avakar/omicron2/v2.0/board/omicron2.brd

## EAGLE design v2.0/board/omicron2.brd (2013-05-29)

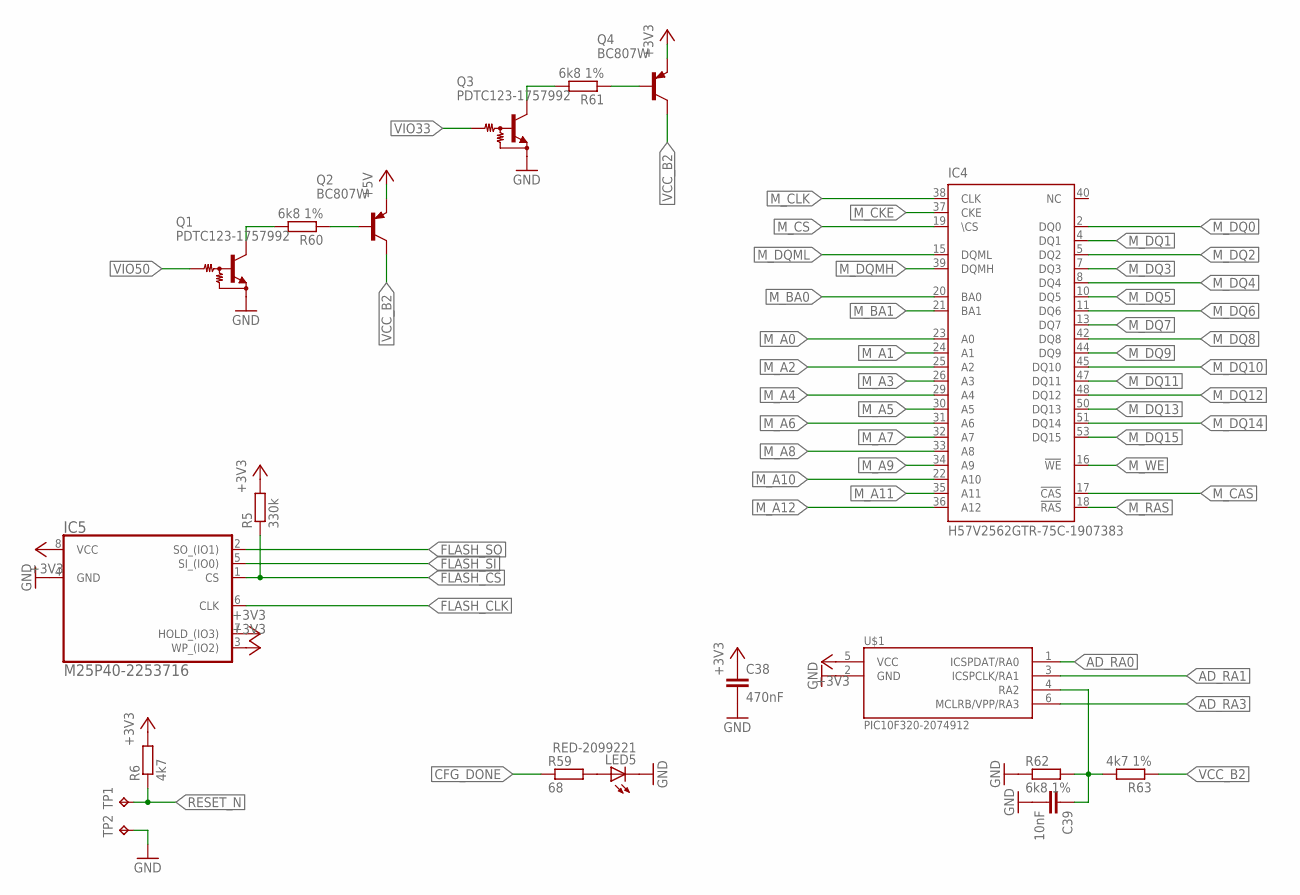
[picture p1: schematic omicron2.sch, sheet 1]

Parts:
C38: 470nF; C0603
C39: 10nF; C0603
IC4: H57V2562GTR-75C-1907383; TSOP54-400
IC5: M25P40-2253716; SO8
LED5: RED-2099221; CHIPLED_0603
Q1, Q3: PDTC123-1757992; SOT323
Q2, Q4: BC807W; SOT323-BEC
R5: 330k; R0603
R6: 4k7; R0603
R59: 68; R0603
R60, R61, R62: 6k8 1%; R0603
R63: 4k7 1%; R0603
TP1: TPTP15R; TP15R
TP2: TPTP20R; TP20R
U$1: PIC10F320-2074912; SOT23

Connections:
+3V3: C38.1, IC5.3 (WP_(IO2)), IC5.7 (HOLD_(IO3)), IC5.8 (VCC), Q4.2 (E), R5.2, R6.2, U$1.5 (VCC); also elsewhere on the board
+5V: Q2.2 (E); also elsewhere on the board
AD_RA0: U$1.1 (ICSPDAT/RA0); also elsewhere on the board
AD_RA1: U$1.3 (ICSPCLK/RA1); also elsewhere on the board
AD_RA3: U$1.6 (MCLRB/VPP/RA3); also elsewhere on the board
CFG_DONE: R59.1; also elsewhere on the board
FLASH_CLK: IC5.6 (CLK); also elsewhere on the board
FLASH_CS: IC5.1 (CS), R5.1; also elsewhere on the board
FLASH_SI: IC5.5 (SI_(IO0)); also elsewhere on the board
FLASH_SO: IC5.2 (SO_(IO1)); also elsewhere on the board
GND: C38.2, C39.2, IC5.4 (GND), LED5.C, Q1.2 (E), Q3.2 (E), R62.1, TP2.TP, U$1.2 (GND); also elsewhere on the board
M_A0: IC4.23 (A0); also elsewhere on the board
M_A1: IC4.24 (A1); also elsewhere on the board
M_A2: IC4.25 (A2); also elsewhere on the board
M_A3: IC4.26 (A3); also elsewhere on the board
M_A4: IC4.29 (A4); also elsewhere on the board
M_A5: IC4.30 (A5); also elsewhere on the board
M_A6: IC4.31 (A6); also elsewhere on the board
M_A7: IC4.32 (A7); also elsewhere on the board
M_A8: IC4.33 (A8); also elsewhere on the board
M_A9: IC4.34 (A9); also elsewhere on the board
M_A10: IC4.22 (A10); also elsewhere on the board
M_A11: IC4.35 (A11); also elsewhere on the board
M_A12: IC4.36 (A12); also elsewhere on the board
M_BA0: IC4.20 (BA0); also elsewhere on the board
M_BA1: IC4.21 (BA1); also elsewhere on the board
M_CAS: IC4.17 (!CAS); also elsewhere on the board
M_CKE: IC4.37 (CKE); also elsewhere on the board
M_CLK: IC4.38 (CLK); also elsewhere on the board
M_CS: IC4.19 (\CS); also elsewhere on the board
M_DQ0: IC4.2 (DQ0); also elsewhere on the board
M_DQ1: IC4.4 (DQ1); also elsewhere on the board
M_DQ2: IC4.5 (DQ2); also elsewhere on the board
M_DQ3: IC4.7 (DQ3); also elsewhere on the board
M_DQ4: IC4.8 (DQ4); also elsewhere on the board
M_DQ5: IC4.10 (DQ5); also elsewhere on the board
M_DQ6: IC4.11 (DQ6); also elsewhere on the board
M_DQ7: IC4.13 (DQ7); also elsewhere on the board
M_DQ8: IC4.42 (DQ8); also elsewhere on the board
M_DQ9: IC4.44 (DQ9); also elsewhere on the board
M_DQ10: IC4.45 (DQ10); also elsewhere on the board
M_DQ11: IC4.47 (DQ11); also elsewhere on the board
M_DQ12: IC4.48 (DQ12); also elsewhere on the board
M_DQ13: IC4.50 (DQ13); also elsewhere on the board
M_DQ14: IC4.51 (DQ14); also elsewhere on the board
M_DQ15: IC4.53 (DQ15); also elsewhere on the board
M_DQMH: IC4.39 (DQMH); also elsewhere on the board
M_DQML: IC4.15 (DQML); also elsewhere on the board
M_RAS: IC4.18 (!RAS); also elsewhere on the board
M_WE: IC4.16 (!WE); also elsewhere on the board
unnamed: LED5.A, R59.2
unnamed: Q2.1 (B), R60.1
unnamed: Q1.3 (C), R60.2
unnamed: Q4.1 (B), R61.1
unnamed: Q3.3 (C), R61.2
unnamed: C39.1, R62.2, R63.2, U$1.4 (RA2)
RESET_N: R6.1, TP1.TP; also elsewhere on the board
VCC_B2: Q2.3 (C), Q4.3 (C), R63.1; also elsewhere on the board
VIO33: Q3.1 (B); also elsewhere on the board
VIO50: Q1.1 (B); also elsewhere on the board

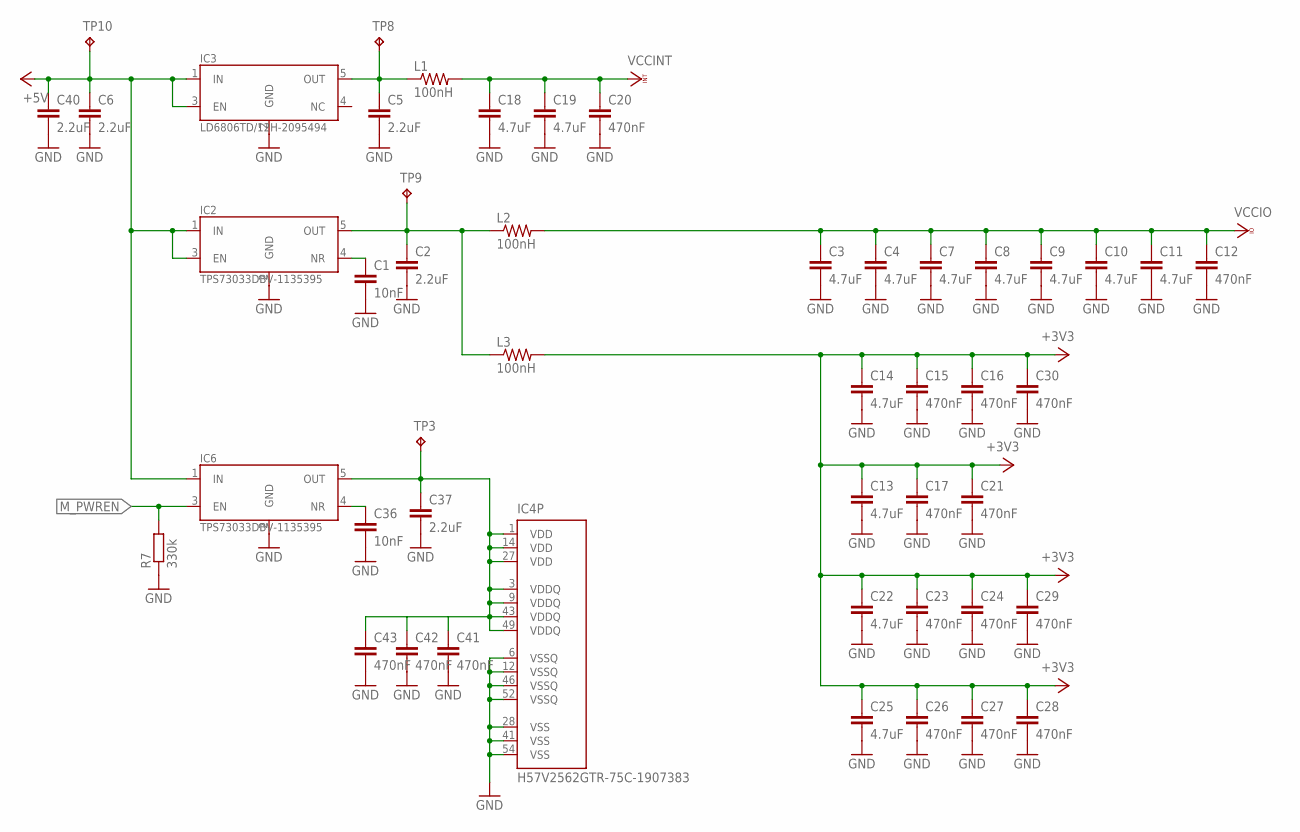
[picture p2: schematic omicron2.sch, sheet 2]

Parts:
C1, C36: 10nF; C0603
C2, C5, C6, C37, C40: 2.2uF; C0603
C3, C4, C7, C8, C9, C10, C11, C13, C14, C18, C19, C22, C25: 4.7uF; C0603
C12, C15, C16, C17, C20, C21, C23, C24, C26, C27, C28, C29, C30, C41, C42, C43: 470nF; C0603
IC2, IC6: TPS73033DBV-1135395; SOT23-DBV
IC3: LD6806TD/12H-2095494; SOT23-DBV
IC4: H57V2562GTR-75C-1907383; TSOP54-400
L1, L2, L3: 100nH; R0805
R7: 330k; R0603
TP3, TP8, TP9, TP10: TPTP15R; TP15R

Connections:
+3V3: C13.1, C14.1, C15.1, C16.1, C17.1, C21.1, C22.1, C23.1, C24.1, C25.1, C26.1, C27.1, C28.1, C29.1, C30.1, L3.2; also elsewhere on the board
+5V: C6.1, C40.1, IC2.1 (IN), IC2.3 (EN), IC3.1 (IN), IC3.3 (EN), IC6.1 (IN), TP10.TP; also elsewhere on the board
GND: C1.2, C2.2, C3.2, C4.2, C5.2, C6.2, C7.2, C8.2, C9.2, C10.2, C11.2, C12.2, C13.2, C14.2, C15.2, C16.2, C17.2, C18.2, C19.2, C20.2, C21.2, C22.2, C23.2, C24.2, C25.2, C26.2, C27.2, C28.2, C29.2, C30.2, C36.2, C37.2, C40.2, C41.2, C42.2, C43.2, IC2.2 (GND), IC3.2 (GND), IC4.6 (VSSQ), IC4.12 (VSSQ), IC4.28 (VSS), IC4.41 (VSS), IC4.46 (VSSQ), IC4.52 (VSSQ), IC4.54 (VSS), IC6.2 (GND), R7.1; also elsewhere on the board
M_PWREN: IC6.3 (EN), R7.2; also elsewhere on the board
unnamed: C1.1, IC2.4 (NR)
unnamed: C5.1, IC3.5 (OUT), L1.1, TP8.TP
unnamed: C2.1, IC2.5 (OUT), L2.1, L3.1, TP9.TP
unnamed: C36.1, IC6.4 (NR)
VCCINT: C18.1, C19.1, C20.1, L1.2; also elsewhere on the board
VCCIO: C3.1, C4.1, C7.1, C8.1, C9.1, C10.1, C11.1, C12.1, L2.2; also elsewhere on the board
VCC_MEM: C37.1, C41.1, C42.1, C43.1, IC4.1 (VDD), IC4.3 (VDDQ), IC4.9 (VDDQ), IC4.14 (VDD), IC4.27 (VDD), IC4.43 (VDDQ), IC4.49 (VDDQ), IC6.5 (OUT), TP3.TP

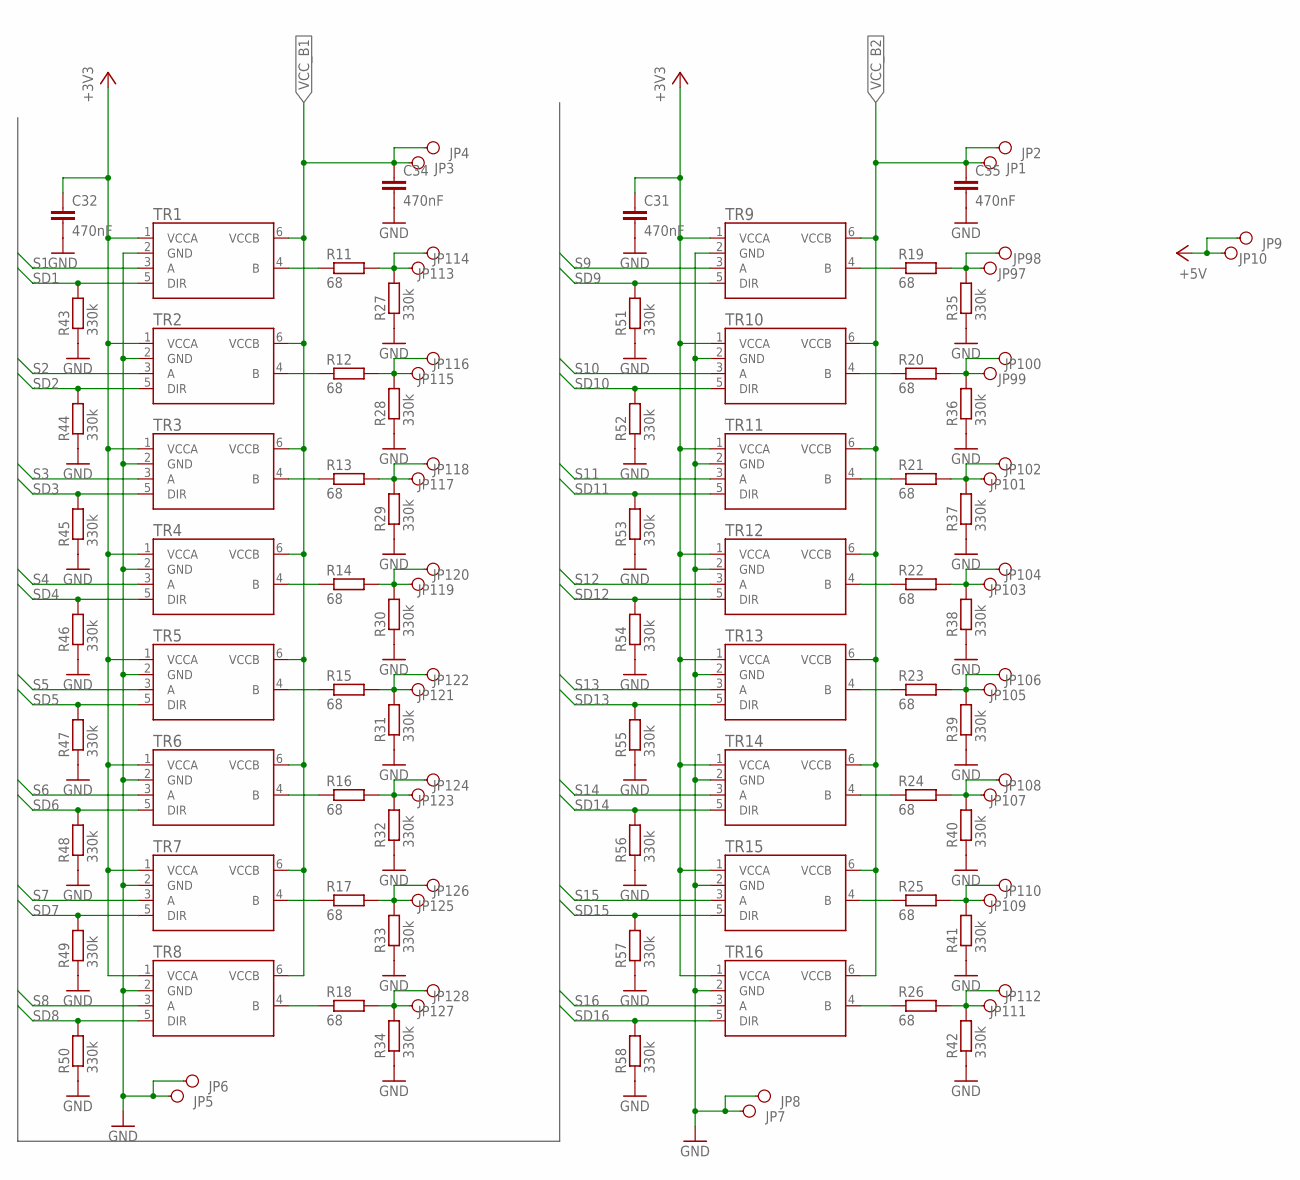
[picture p3: schematic omicron2.sch, sheet 3]

Parts:
C31, C32, C34, C35: 470nF; C0603
JP1, JP2, JP3, JP4, JP5, JP6, JP7, JP8, JP9, JP10, JP97, JP98, JP99, JP100, JP101, JP102, JP103, JP104, JP105, JP106, JP107, JP108, JP109, JP110, JP111, JP112, JP113, JP114, JP115, JP116, JP117, JP118, JP119, JP120, JP121, JP122, JP123, JP124, JP125, JP126, JP127, JP128: PINH1X01SMD
R11, R12, R13, R14, R15, R16, R17, R18, R19, R20, R21, R22, R23, R24, R25, R26: 68; R0603
R27, R28, R29, R30, R31, R32, R33, R34, R35, R36, R37, R38, R39, R40, R41, R42, R43, R44, R45, R46, R47, R48, R49, R50, R51, R52, R53, R54, R55, R56, R57, R58: 330k; R0603
TR1, TR2, TR3, TR4, TR5, TR6, TR7, TR8, TR9, TR10, TR11, TR12, TR13, TR14, TR15, TR16: 74LVC1T45DBV; SOT236

Connections:
+3V3: C31.1, C32.1, TR1.1 (VCCA), TR2.1 (VCCA), TR3.1 (VCCA), TR4.1 (VCCA), TR5.1 (VCCA), TR6.1 (VCCA), TR7.1 (VCCA), TR8.1 (VCCA), TR9.1 (VCCA), TR10.1 (VCCA), TR11.1 (VCCA), TR12.1 (VCCA), TR13.1 (VCCA), TR14.1 (VCCA), TR15.1 (VCCA), TR16.1 (VCCA); also elsewhere on the board
+5V: JP9.1, JP10.1; also elsewhere on the board
GND: C31.2, C32.2, C34.2, C35.2, JP5.1, JP6.1, JP7.1, JP8.1, R27.1, R28.1, R29.1, R30.1, R31.1, R32.1, R33.1, R34.1, R35.1, R36.1, R37.1, R38.1, R39.1, R40.1, R41.1, R42.1, R43.1, R44.1, R45.1, R46.1, R47.1, R48.1, R49.1, R50.1, R51.1, R52.1, R53.1, R54.1, R55.1, R56.1, R57.1, R58.1, TR1.2 (GND), TR2.2 (GND), TR3.2 (GND), TR4.2 (GND), TR5.2 (GND), TR6.2 (GND), TR7.2 (GND), TR8.2 (GND), TR9.2 (GND), TR10.2 (GND), TR11.2 (GND), TR12.2 (GND), TR13.2 (GND), TR14.2 (GND), TR15.2 (GND), TR16.2 (GND); also elsewhere on the board
IO1: JP113.1, JP114.1, R11.2, R27.2
IO2: JP115.1, JP116.1, R12.2, R28.2
IO3: JP117.1, JP118.1, R13.2, R29.2
IO4: JP119.1, JP120.1, R14.2, R30.2
IO5: JP121.1, JP122.1, R15.2, R31.2
IO6: JP123.1, JP124.1, R16.2, R32.2
IO7: JP125.1, JP126.1, R17.2, R33.2
IO8: JP127.1, JP128.1, R18.2, R34.2
IO9: JP97.1, JP98.1, R19.2, R35.2
IO10: JP99.1, JP100.1, R20.2, R36.2
IO11: JP101.1, JP102.1, R21.2, R37.2
IO12: JP103.1, JP104.1, R22.2, R38.2
IO13: JP105.1, JP106.1, R23.2, R39.2
IO14: JP107.1, JP108.1, R24.2, R40.2
IO15: JP109.1, JP110.1, R25.2, R41.2
IO16: JP111.1, JP112.1, R26.2, R42.2
unnamed: R11.1, TR1.4 (B)
unnamed: R12.1, TR2.4 (B)
unnamed: R13.1, TR3.4 (B)
unnamed: R14.1, TR4.4 (B)
unnamed: R15.1, TR5.4 (B)
unnamed: R16.1, TR6.4 (B)
unnamed: R17.1, TR7.4 (B)
unnamed: R18.1, TR8.4 (B)
unnamed: R19.1, TR9.4 (B)
unnamed: R20.1, TR10.4 (B)
unnamed: R21.1, TR11.4 (B)
unnamed: R22.1, TR12.4 (B)
unnamed: R23.1, TR13.4 (B)
unnamed: R24.1, TR14.4 (B)
unnamed: R25.1, TR15.4 (B)
unnamed: R26.1, TR16.4 (B)
S1: TR1.3 (A); also elsewhere on the board
S2: TR2.3 (A); also elsewhere on the board
S3: TR3.3 (A); also elsewhere on the board
S4: TR4.3 (A); also elsewhere on the board
S5: TR5.3 (A); also elsewhere on the board
S6: TR6.3 (A); also elsewhere on the board
S7: TR7.3 (A); also elsewhere on the board
S8: TR8.3 (A); also elsewhere on the board
S9: TR9.3 (A); also elsewhere on the board
S10: TR10.3 (A); also elsewhere on the board
S11: TR11.3 (A); also elsewhere on the board
S12: TR12.3 (A); also elsewhere on the board
S13: TR13.3 (A); also elsewhere on the board
S14: TR14.3 (A); also elsewhere on the board
S15: TR15.3 (A); also elsewhere on the board
S16: TR16.3 (A); also elsewhere on the board
SD1: R43.2, TR1.5 (DIR); also elsewhere on the board
SD2: R44.2, TR2.5 (DIR); also elsewhere on the board
SD3: R45.2, TR3.5 (DIR); also elsewhere on the board
SD4: R46.2, TR4.5 (DIR); also elsewhere on the board
SD5: R47.2, TR5.5 (DIR); also elsewhere on the board
SD6: R48.2, TR6.5 (DIR); also elsewhere on the board
SD7: R49.2, TR7.5 (DIR); also elsewhere on the board
SD8: R50.2, TR8.5 (DIR); also elsewhere on the board
SD9: R51.2, TR9.5 (DIR); also elsewhere on the board
SD10: R52.2, TR10.5 (DIR); also elsewhere on the board
SD11: R53.2, TR11.5 (DIR); also elsewhere on the board
SD12: R54.2, TR12.5 (DIR); also elsewhere on the board
SD13: R55.2, TR13.5 (DIR); also elsewhere on the board
SD14: R56.2, TR14.5 (DIR); also elsewhere on the board
SD15: R57.2, TR15.5 (DIR); also elsewhere on the board
SD16: R58.2, TR16.5 (DIR); also elsewhere on the board
VCC_B1: C34.1, JP3.1, JP4.1, TR1.6 (VCCB), TR2.6 (VCCB), TR3.6 (VCCB), TR4.6 (VCCB), TR5.6 (VCCB), TR6.6 (VCCB), TR7.6 (VCCB), TR8.6 (VCCB)
VCC_B2: C35.1, JP1.1, JP2.1, TR9.6 (VCCB), TR10.6 (VCCB), TR11.6 (VCCB), TR12.6 (VCCB), TR13.6 (VCCB), TR14.6 (VCCB), TR15.6 (VCCB), TR16.6 (VCCB); also elsewhere on the board

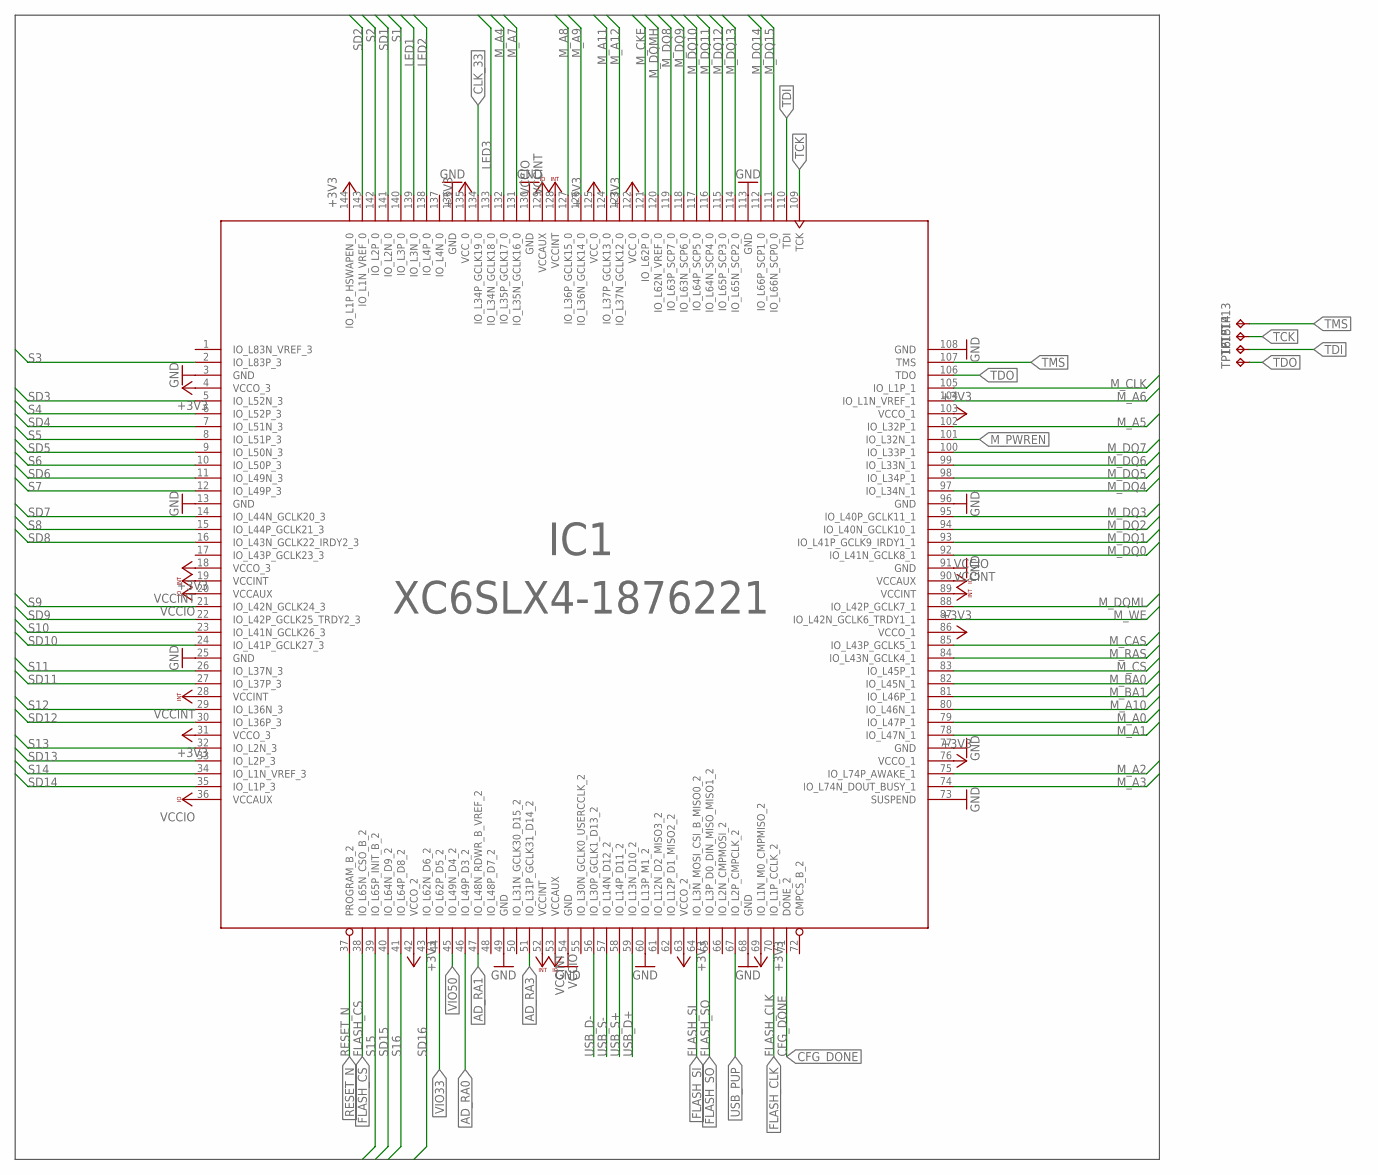
[picture p4: schematic omicron2.sch, sheet 4]

Parts:
IC1: XC6SLX4-1876221; TQG144
TP13, TP14, TP15, TP16: TPTP20R; TP20R

Connections:
+3V3: IC1.4 (VCCO_3), IC1.18 (VCCO_3), IC1.31 (VCCO_3), IC1.42 (VCCO_2), IC1.63 (VCCO_2), IC1.69 (IO_L1N_M0_CMPMISO_2), IC1.76 (VCCO_1), IC1.86 (VCCO_1), IC1.103 (VCCO_1), IC1.122 (VCC_0), IC1.125 (VCC_0), IC1.135 (VCC_0), IC1.144 (IO_L1P_HSWAPEN_0); also elsewhere on the board
AD_RA0: IC1.46 (IO_L49P_D3_2); also elsewhere on the board
AD_RA1: IC1.47 (IO_L48N_RDWR_B_VREF_2); also elsewhere on the board
AD_RA3: IC1.51 (IO_L31P_GCLK31_D14_2); also elsewhere on the board
CFG_DONE: IC1.71 (DONE_2); also elsewhere on the board
CLK_33: IC1.134 (IO_L34P_GCLK19_0); also elsewhere on the board
FLASH_CLK: IC1.70 (IO_L1P_CCLK_2); also elsewhere on the board
FLASH_CS: IC1.38 (IO_L65N_CSO_B_2); also elsewhere on the board
FLASH_SI: IC1.64 (IO_L3N_MOSI_CSI_B_MISO0_2); also elsewhere on the board
FLASH_SO: IC1.65 (IO_L3P_D0_DIN_MISO_MISO1_2); also elsewhere on the board
GND: IC1.3 (GND), IC1.13 (GND), IC1.25 (GND), IC1.49 (GND), IC1.54 (GND), IC1.60 (IO_L13P_M1_2), IC1.68 (GND), IC1.73 (SUSPEND), IC1.77 (GND), IC1.91 (GND), IC1.96 (GND), IC1.108 (GND), IC1.113 (GND), IC1.130 (GND), IC1.136 (GND); also elsewhere on the board
LED1: IC1.139 (IO_L3N_0); also elsewhere on the board
LED2: IC1.138 (IO_L4P_0); also elsewhere on the board
LED3: IC1.133 (IO_L34N_GCLK18_0); also elsewhere on the board
M_A0: IC1.79 (IO_L47P_1); also elsewhere on the board
M_A1: IC1.78 (IO_L47N_1); also elsewhere on the board
M_A2: IC1.75 (IO_L74P_AWAKE_1); also elsewhere on the board
M_A3: IC1.74 (IO_L74N_DOUT_BUSY_1); also elsewhere on the board
M_A4: IC1.132 (IO_L35P_GCLK17_0); also elsewhere on the board
M_A5: IC1.102 (IO_L32P_1); also elsewhere on the board
M_A6: IC1.104 (IO_L1N_VREF_1); also elsewhere on the board
M_A7: IC1.131 (IO_L35N_GCLK16_0); also elsewhere on the board
M_A8: IC1.127 (IO_L36P_GCLK15_0); also elsewhere on the board
M_A9: IC1.126 (IO_L36N_GCLK14_0); also elsewhere on the board
M_A10: IC1.80 (IO_L46N_1); also elsewhere on the board
M_A11: IC1.124 (IO_L37P_GCLK13_0); also elsewhere on the board
M_A12: IC1.123 (IO_L37N_GCLK12_0); also elsewhere on the board
M_BA0: IC1.82 (IO_L45N_1); also elsewhere on the board
M_BA1: IC1.81 (IO_L46P_1); also elsewhere on the board
M_CAS: IC1.85 (IO_L43P_GCLK5_1); also elsewhere on the board
M_CKE: IC1.121 (IO_L62P_0); also elsewhere on the board
M_CLK: IC1.105 (IO_L1P_1); also elsewhere on the board
M_CS: IC1.83 (IO_L45P_1); also elsewhere on the board
M_DQ0: IC1.92 (IO_L41N_GCLK8_1); also elsewhere on the board
M_DQ1: IC1.93 (IO_L41P_GCLK9_IRDY1_1); also elsewhere on the board
M_DQ2: IC1.94 (IO_L40N_GCLK10_1); also elsewhere on the board
M_DQ3: IC1.95 (IO_L40P_GCLK11_1); also elsewhere on the board
M_DQ4: IC1.97 (IO_L34N_1); also elsewhere on the board
M_DQ5: IC1.98 (IO_L34P_1); also elsewhere on the board
M_DQ6: IC1.99 (IO_L33N_1); also elsewhere on the board
M_DQ7: IC1.100 (IO_L33P_1); also elsewhere on the board
M_DQ8: IC1.119 (IO_L63P_SCP7_0); also elsewhere on the board
M_DQ9: IC1.118 (IO_L63N_SCP6_0); also elsewhere on the board
M_DQ10: IC1.117 (IO_L64P_SCP5_0); also elsewhere on the board
M_DQ11: IC1.116 (IO_L64N_SCP4_0); also elsewhere on the board
M_DQ12: IC1.115 (IO_L65P_SCP3_0); also elsewhere on the board
M_DQ13: IC1.114 (IO_L65N_SCP2_0); also elsewhere on the board
M_DQ14: IC1.112 (IO_L66P_SCP1_0); also elsewhere on the board
M_DQ15: IC1.111 (IO_L66N_SCP0_0); also elsewhere on the board
M_DQMH: IC1.120 (IO_L62N_VREF_0); also elsewhere on the board
M_DQML: IC1.88 (IO_L42P_GCLK7_1); also elsewhere on the board
M_PWREN: IC1.101 (IO_L32N_1); also elsewhere on the board
M_RAS: IC1.84 (IO_L43N_GCLK4_1); also elsewhere on the board
M_WE: IC1.87 (IO_L42N_GCLK6_TRDY1_1); also elsewhere on the board
RESET_N: IC1.37 (PROGRAM_B_2); also elsewhere on the board
S1: IC1.140 (IO_L3P_0); also elsewhere on the board
S2: IC1.142 (IO_L2P_0); also elsewhere on the board
S3: IC1.2 (IO_L83P_3); also elsewhere on the board
S4: IC1.6 (IO_L52P_3); also elsewhere on the board
S5: IC1.8 (IO_L51P_3); also elsewhere on the board
S6: IC1.10 (IO_L50P_3); also elsewhere on the board
S7: IC1.12 (IO_L49P_3); also elsewhere on the board
S8: IC1.15 (IO_L44P_GCLK21_3); also elsewhere on the board
S9: IC1.21 (IO_L42N_GCLK24_3); also elsewhere on the board
S10: IC1.23 (IO_L41N_GCLK26_3); also elsewhere on the board
S11: IC1.26 (IO_L37N_3); also elsewhere on the board
S12: IC1.29 (IO_L36N_3); also elsewhere on the board
S13: IC1.32 (IO_L2N_3); also elsewhere on the board
S14: IC1.34 (IO_L1N_VREF_3); also elsewhere on the board
S15: IC1.39 (IO_L65P_INIT_B_2); also elsewhere on the board
S16: IC1.41 (IO_L64P_D8_2); also elsewhere on the board
SD1: IC1.141 (IO_L2N_0); also elsewhere on the board
SD2: IC1.143 (IO_L1N_VREF_0); also elsewhere on the board
SD3: IC1.5 (IO_L52N_3); also elsewhere on the board
SD4: IC1.7 (IO_L51N_3); also elsewhere on the board
SD5: IC1.9 (IO_L50N_3); also elsewhere on the board
SD6: IC1.11 (IO_L49N_3); also elsewhere on the board
SD7: IC1.14 (IO_L44N_GCLK20_3); also elsewhere on the board
SD8: IC1.16 (IO_L43N_GCLK22_IRDY2_3); also elsewhere on the board
SD9: IC1.22 (IO_L42P_GCLK25_TRDY2_3); also elsewhere on the board
SD10: IC1.24 (IO_L41P_GCLK27_3); also elsewhere on the board
SD11: IC1.27 (IO_L37P_3); also elsewhere on the board
SD12: IC1.30 (IO_L36P_3); also elsewhere on the board
SD13: IC1.33 (IO_L2P_3); also elsewhere on the board
SD14: IC1.35 (IO_L1P_3); also elsewhere on the board
SD15: IC1.40 (IO_L64N_D9_2); also elsewhere on the board
SD16: IC1.43 (IO_L62N_D6_2); also elsewhere on the board
TCK: IC1.109 (TCK), TP14.TP
TDI: IC1.110 (TDI), TP15.TP
TDO: IC1.106 (TDO), TP16.TP
TMS: IC1.107 (TMS), TP13.TP
USB_D+: IC1.59 (IO_L13N_D10_2); also elsewhere on the board
USB_D-: IC1.56 (IO_L30P_GCLK1_D13_2); also elsewhere on the board
USB_PUP: IC1.67 (IO_L2P_CMPCLK_2); also elsewhere on the board
USB_S+: IC1.58 (IO_L14P_D11_2); also elsewhere on the board
USB_S-: IC1.57 (IO_L14N_D12_2); also elsewhere on the board
VCCINT: IC1.19 (VCCINT), IC1.28 (VCCINT), IC1.52 (VCCINT), IC1.89 (VCCINT), IC1.128 (VCCINT); also elsewhere on the board
VCCIO: IC1.20 (VCCAUX), IC1.36 (VCCAUX), IC1.53 (VCCAUX), IC1.90 (VCCAUX), IC1.129 (VCCAUX); also elsewhere on the board
VIO33: IC1.44 (IO_L62P_D5_2); also elsewhere on the board
VIO50: IC1.45 (IO_L49N_D4_2); also elsewhere on the board

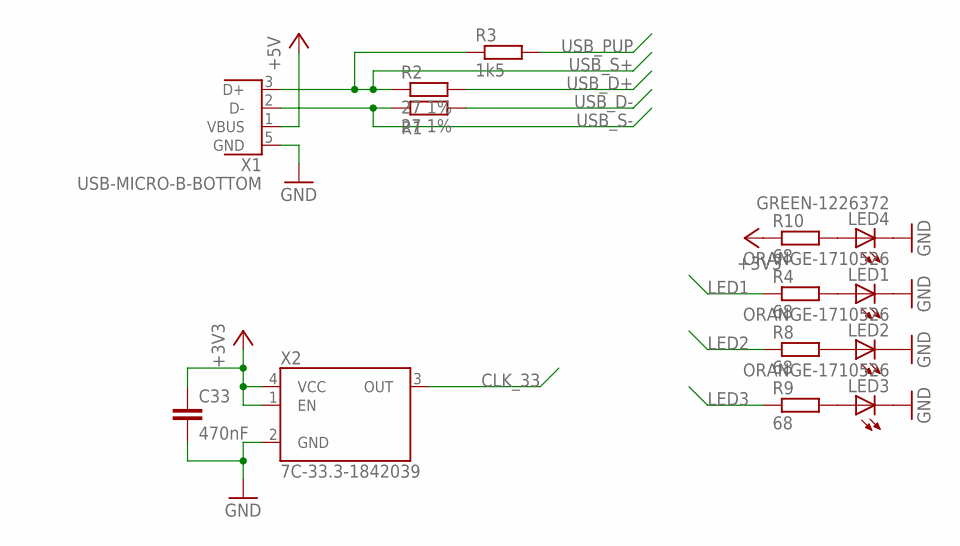
[picture p5: schematic omicron2.sch, sheet 5]

Parts:
C33: 470nF; C0603
LED1, LED2, LED3: ORANGE-1710526; CHIPLED_0603
LED4: GREEN-1226372; CHIPLED_0603
R1, R2: 27 1%; R0603
R3: 1k5; R0603
R4, R8, R9, R10: 68; R0603
X1: USB-MICRO-B-BOTTOM; USB-MICRO-B-BOTTOM-MOLEX
X2: 7C-33.3-1842039; 5X3.2_HAND

Connections:
+3V3: C33.1, R10.1, X2.1 (EN), X2.4 (VCC); also elsewhere on the board
+5V: X1.1 (VBUS); also elsewhere on the board
CLK_33: X2.3 (OUT); also elsewhere on the board
GND: C33.2, LED1.C, LED2.C, LED3.C, LED4.C, X1.5 (GND), X2.2 (GND); also elsewhere on the board
LED1: R4.1; also elsewhere on the board
LED2: R8.1; also elsewhere on the board
LED3: R9.1; also elsewhere on the board
unnamed: LED1.A, R4.2
unnamed: LED2.A, R8.2
unnamed: LED3.A, R9.2
unnamed: LED4.A, R10.2
USB_D+: R2.2; also elsewhere on the board
USB_D-: R1.2; also elsewhere on the board
USB_PUP: R3.2; also elsewhere on the board
USB_S+: R2.1, R3.1, X1.3 (D+); also elsewhere on the board
USB_S-: R1.1, X1.2 (D-); also elsewhere on the board

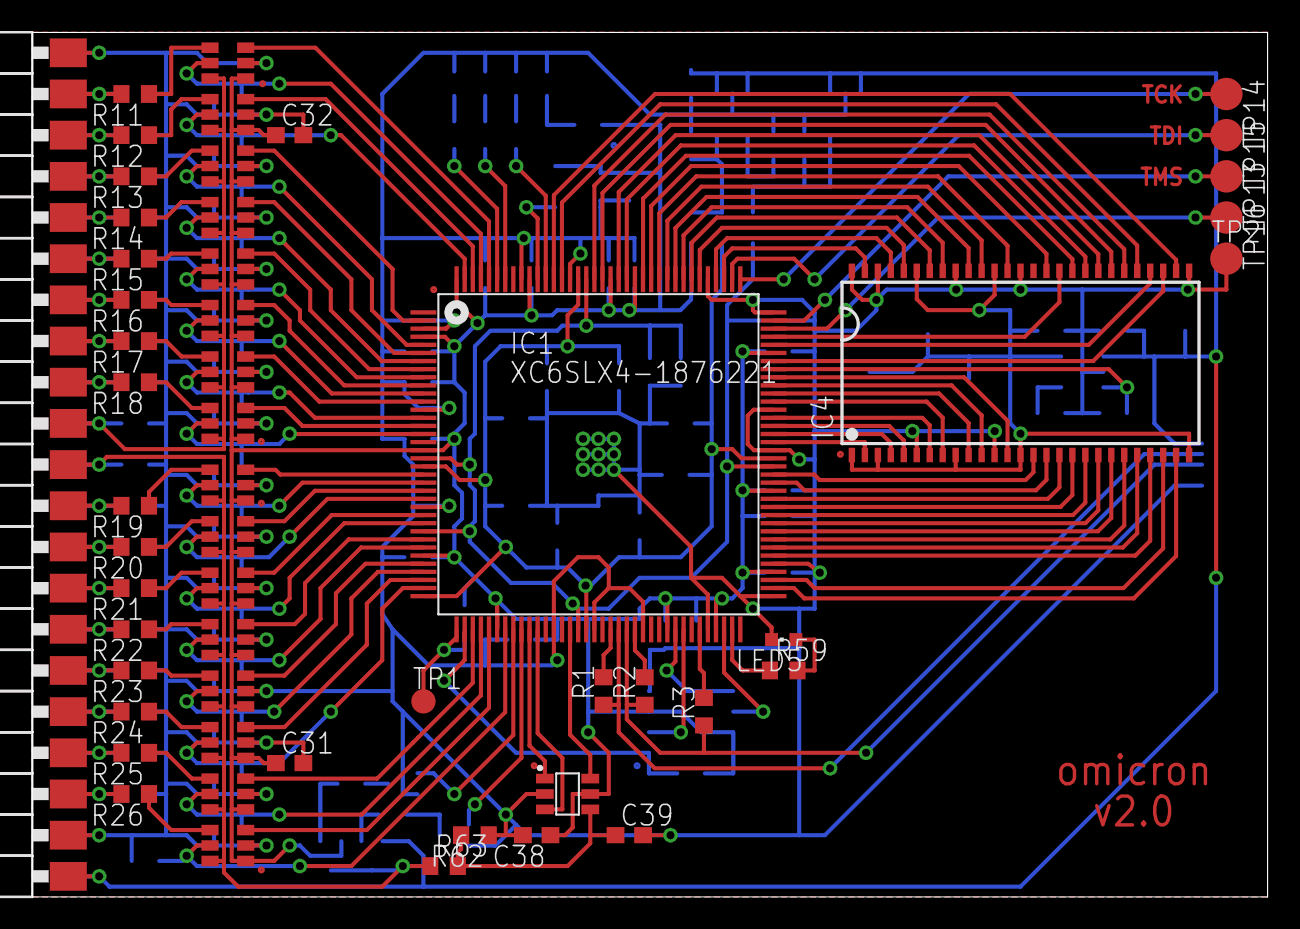
[picture p6: board omicron2.brd from above]

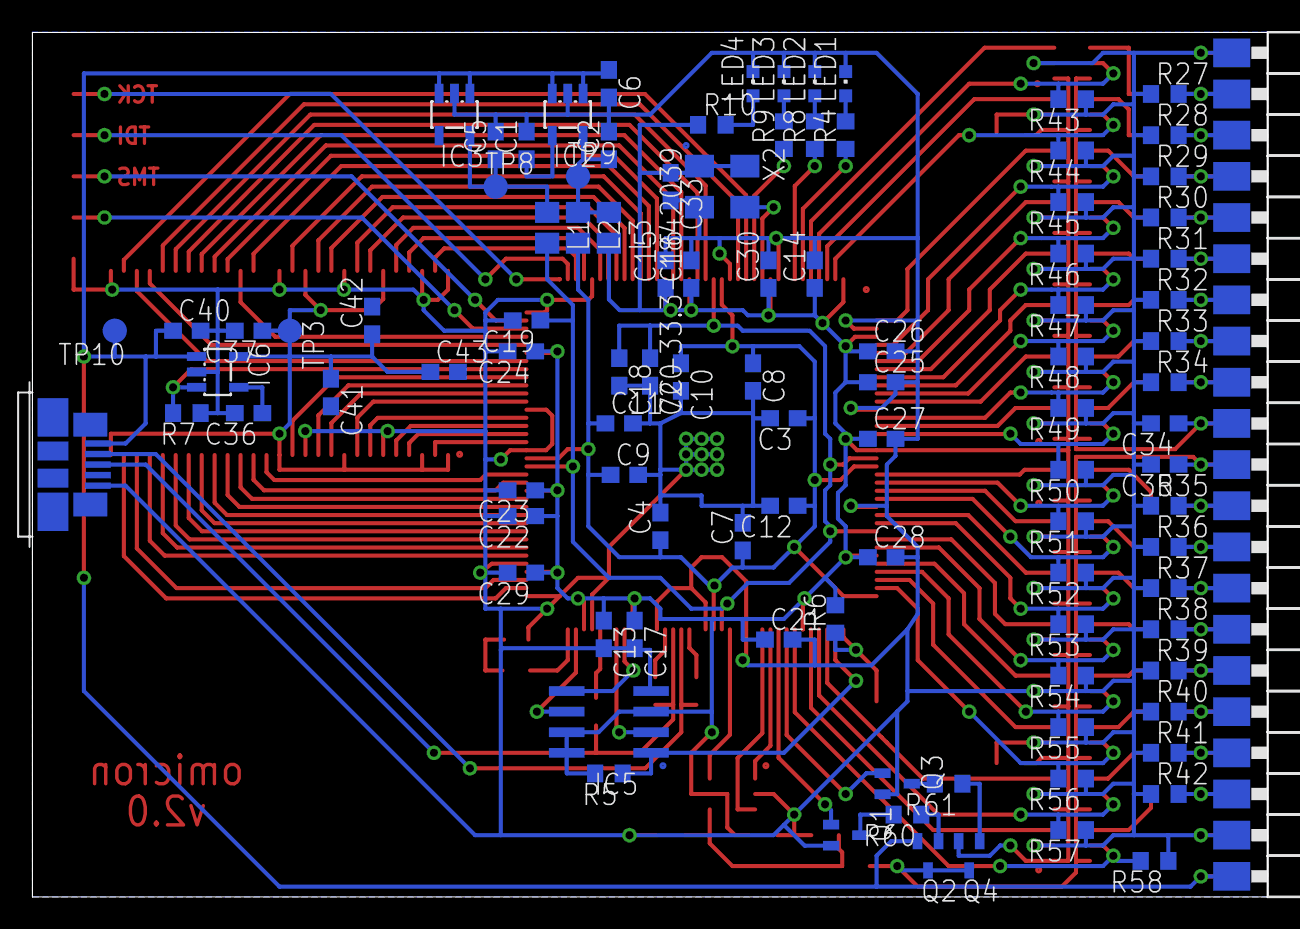
[picture p7: board omicron2.brd from below]

Board: 2 copper layers, 76.2 x 53.3 mm, 195 parts (122 on the bottom side), 150 nets.
