avakar/omicron2/v2.0/design/ipcore_dir/workspace/sw_0/src/main.cc

/*
 * Empty C++ Application
 */

#include <stdint.h>
#include <stdlib.h>
#include <string.h>

#define PROGMEM
#include "descs.h"

#define UART_RX     *((uint32_t volatile *)0x80000000)
#define UART_TX     *((uint32_t volatile *)0x80000004)
#define UART_STATUS *((uint32_t volatile *)0x80000008)
#define UART_TX_USED_bm  (1<<3)
#define UART_RX_VALID_bm (1<<0)

#define USB_CTRL    *((uint32_t volatile *)0xC0000000)
#define USB_ATTACH    (1<<0)
#define USB_RESET_IF  (1<<1)
#define USB_RESET_CLR (1<<2)
#define USB_ADDRESS *((uint32_t volatile *)0xC0000004)

#define USB_EP0_OUT_CTRL *((uint32_t volatile *)0xC0000100)
#define USB_EP0_IN_CTRL  *((uint32_t volatile *)0xC0000104)

#define USB_EP1_OUT_CTRL *((uint32_t volatile *)0xC0000110)
#define USB_EP1_IN_CTRL  *((uint32_t volatile *)0xC0000114)

#define USB_EP_OUT_CNT(x) ((uint8_t)(((x) >> 8) & 0x3f))
#define USB_EP_IN_CNT(x)  ((uint8_t)(x) << 8)

#define USB_EP_TOGGLE     (1<<5)
#define USB_EP_TOGGLE_SET (1<<6)
#define USB_EP_TOGGLE_CLR (1<<7)
#define USB_EP_STALL      (1<<4)
#define USB_EP_SETUP_CLR  (1<<3)
#define USB_EP_SETUP      (1<<2)
#define USB_EP_FULL_CLR   (1<<1)
#define USB_EP_FULL       (1<<0)

#define USB_EP0_OUT ((uint8_t volatile *)0xC1000000)
#define USB_EP0_IN  ((uint8_t volatile *)0xC1000080)
#define USB_EP1_OUT ((uint8_t volatile *)0xC1000100)
#define USB_EP1_IN  ((uint8_t volatile *)0xC1000180)
#define USB_EP2_OUT ((uint8_t volatile *)0xC1000200)
#define USB_EP2_IN  ((uint8_t volatile *)0xC1000280)
#define USB_EP3_OUT ((uint8_t volatile *)0xC1000300)
#define USB_EP3_IN  ((uint8_t volatile *)0xC1000380)

#define DNA_DATA    *((uint64_t volatile *)0xC2000000)

#define DRAM_CTRL   *((uint32_t volatile *)0xC0000008)
#define DRAM_ENABLE (1<<0)

#define SAMPLER_FIFO_CTRL *((uint32_t volatile *)0xC2000010)
#define SAMPLER_FIFO_DATA *((uint16_t volatile *)0xC2000014)
#define SAMPLER_CTRL      *((uint32_t volatile *)0xC2000100)
#define SAMPLER_PERIOD    *((uint32_t volatile *)0xC2000104)
#define SAMPLER_EDGE      *((uint32_t volatile *)0xC2000108)
#define SAMPLER_MUXL      *((uint32_t volatile *)0xC2000110)
#define SAMPLER_MUXH      *((uint32_t volatile *)0xC2000114)

#define SAMPLER_FIFO_RDY  (1<<0)
#define SAMPLER_ENABLE    (1<<0)
#define SAMPLER_CLEAR_TIMER (1<<1)
#define SAMPLER_CLEAR_PIPELINE     (1<<2)
#define SAMPLER_LOG_CHANNELS_gp (4)

#define DRAM16      ((uint32_t volatile *)0xD0000000)

#if 0
static void sendch(char ch)
{
	while (UART_STATUS & UART_TX_USED_bm)
	{
	}

	UART_TX = ch;
}

static bool rx_ready()
{
	return UART_STATUS & UART_RX_VALID_bm;
}

static uint8_t getch()
{
	return UART_RX;
}
#else

static int const buf_size = 128;
static uint8_t tx_buf[buf_size];
static uint8_t tx_wr_ptr = 0;
static uint8_t tx_rd_ptr = 0;
static uint8_t rx_buf[buf_size];
static uint8_t rx_wr_ptr = 0;
static uint8_t rx_rd_ptr = 0;

static uint8_t buf_next(uint8_t p)
{
	return (p + 1) & (buf_size - 1);
}

static uint8_t buf_diff(uint8_t a, uint8_t b)
{
	return uint8_t(a - b) & (buf_size - 1);
}

static void usb_poll()
{
	if ((USB_EP1_OUT_CTRL & USB_EP_FULL) != 0
			&& buf_size - 1 - buf_diff(rx_wr_ptr, rx_rd_ptr) >= USB_EP_OUT_CNT(USB_EP1_OUT_CTRL))
	{
		uint8_t cnt = USB_EP_OUT_CNT(USB_EP1_OUT_CTRL);
		for (uint8_t i = 0; i < cnt; ++i)
		{
			rx_buf[rx_wr_ptr] = USB_EP1_OUT[i];
			rx_wr_ptr = buf_next(rx_wr_ptr);
		}
		USB_EP1_OUT_CTRL = USB_EP_FULL_CLR;
	}

	if ((USB_EP1_IN_CTRL & USB_EP_FULL) == 0
			&& tx_rd_ptr != tx_wr_ptr)
	{
		uint8_t cnt = buf_diff(tx_wr_ptr, tx_rd_ptr);
		if (cnt > 64)
			cnt = 64;
		for (uint8_t i = 0; i < cnt; ++i)
		{
			USB_EP1_IN[i] = tx_buf[tx_rd_ptr];
			tx_rd_ptr = buf_next(tx_rd_ptr);
		}
		USB_EP1_IN_CTRL = USB_EP_IN_CNT(cnt) | USB_EP_FULL;
	}
}

static void sendch(char ch)
{
	for (;;)
	{
		uint8_t tx_next = buf_next(tx_wr_ptr);
		if (tx_next == tx_rd_ptr)
		{
			usb_poll();
			continue;
		}

		tx_buf[tx_wr_ptr] = ch;
		tx_wr_ptr = tx_next;
		break;
	}
}

static bool rx_ready()
{
	return rx_wr_ptr != rx_rd_ptr;
}

static uint8_t getch()
{
	while (!rx_ready())
		usb_poll();

	uint8_t res = rx_buf[rx_rd_ptr];
	rx_rd_ptr = buf_next(rx_rd_ptr);
	return res;
}

#endif

static void send(char const * s)
{
	while (*s)
		sendch(*s++);
}

static void sendh(uint8_t s)
{
	static char const digits[] = "0123456789abcdef";
	sendch(digits[s >> 4]);
	sendch(digits[s & 0xf]);
}

static void sendh(uint16_t s)
{
	sendh((uint8_t)(s >> 8));
	sendh((uint8_t)s);
}

static void sendh(uint32_t s)
{
	sendh((uint16_t)(s >> 16));
	sendh((uint16_t)s);
}

static void sendh(uint64_t s)
{
	sendh((uint32_t)(s >> 32));
	sendh((uint32_t)s);
}

int main()
{
	USB_CTRL = USB_ATTACH;

	enum { ia_none, ia_set_address } action = ia_none;
	uint8_t new_address = 0;
	uint8_t config = 0;
	uint8_t read_addr = 0;
	uint8_t write_addr = 0;
	uint8_t dram_data = 0;
	for (;;)
	{
		if (USB_CTRL & USB_RESET_IF)
		{
			//send("RESET\n");
			USB_ADDRESS = 0;
			USB_CTRL |= USB_RESET_CLR;
			USB_EP0_IN_CTRL = USB_EP_STALL | USB_EP_FULL_CLR;
			USB_EP0_OUT_CTRL = USB_EP_STALL | USB_EP_FULL | USB_EP_SETUP_CLR;
			USB_EP1_IN_CTRL = USB_EP_STALL | USB_EP_FULL_CLR;
			USB_EP1_OUT_CTRL = USB_EP_STALL | USB_EP_FULL_CLR | USB_EP_SETUP_CLR;
			action = ia_none;
			config = 0;
		}

		if ((USB_EP0_IN_CTRL & USB_EP_FULL) == 0)
		{
			switch (action)
			{
			case ia_none:
				break;
			case ia_set_address:
				USB_ADDRESS = new_address;
				action = ia_none;
				break;
			}
		}

		usb_poll();

		if (USB_EP0_OUT_CTRL & USB_EP_SETUP)
		{
			USB_EP0_IN_CTRL = USB_EP_TOGGLE_SET | USB_EP_FULL_CLR;
			USB_EP0_OUT_CTRL = USB_EP_TOGGLE_SET | USB_EP_SETUP_CLR | USB_EP_FULL;
			action = ia_none;

			uint16_t cmd = (USB_EP0_OUT[0] << 8) | USB_EP0_OUT[1];
			uint16_t wValue = (USB_EP0_OUT[3] << 8) | USB_EP0_OUT[2];
			//uint16_t wIndex = (USB_EP0_OUT[5] << 8) | USB_EP0_OUT[4];
			uint16_t wLength = (USB_EP0_OUT[7] << 8) | USB_EP0_OUT[6];

			/*send("SETUP ");
			sendh(cmd);
			sendch(':');
			sendh(wValue);
			sendch(':');
			sendh(wIndex);
			sendch(':');
			sendh(wLength);
			sendch('\n');*/

			switch (cmd)
			{
			case 0x8006: // get_descriptor
				if (wValue == 0x302)
				{
					uint8_t volatile * p = USB_EP0_IN;
					*p++ = 34;
					*p++ = 3;

					uint64_t dna = DNA_DATA;
					for (int i = 0; i < 16; ++i)
					{
						static char const digits[] = "0123456789abcdef";
						*p++ = digits[dna & 0xf];
						*p++ = 0;
						dna = dna >> 4;
					}

					uint8_t size = wLength > 34? 34: wLength;
					USB_EP0_IN_CTRL = USB_EP_IN_CNT(size) | USB_EP_FULL;
					USB_EP0_OUT_CTRL = USB_EP_FULL_CLR;
				}
				else
				{
					usb_descriptor_entry_t const * selected = 0;
					for (size_t i = 0; !selected && i < sizeof usb_descriptor_map / sizeof usb_descriptor_map[0]; ++i)
					{
						if (usb_descriptor_map[i].index == wValue)
							selected = &usb_descriptor_map[i];
					}

					if (!selected)
					{
						USB_EP0_IN_CTRL = USB_EP_STALL;
						USB_EP0_OUT_CTRL = USB_EP_STALL;
					}
					else
					{
						uint16_t size = selected->size;
						if (size > wLength)
							size = wLength;

						memcpy((void *)USB_EP0_IN, usb_descriptors + selected->offset, size);
						USB_EP0_IN_CTRL = USB_EP_IN_CNT(size) | USB_EP_FULL;
						USB_EP0_OUT_CTRL = USB_EP_FULL_CLR;
					}
				}
				break;
			case 0x0005: // set_address
				new_address = wValue;
				action = ia_set_address;
				USB_EP0_OUT_CTRL = USB_EP_STALL;
				USB_EP0_IN_CTRL = USB_EP_IN_CNT(0) | USB_EP_FULL;
				break;
			case 0x8008: // get_config
				USB_EP0_IN[0] = config;
				USB_EP0_IN_CTRL = USB_EP_IN_CNT(1) | USB_EP_FULL;
				USB_EP0_OUT_CTRL = USB_EP_FULL_CLR;
				break;
			case 0x0009: // set_config
				if (wValue > 1)
				{
					USB_EP0_OUT_CTRL = USB_EP_STALL;
					USB_EP0_IN_CTRL = USB_EP_STALL;
				}
				else
				{
					config = (uint8_t)wValue;

					if (config)
					{
						USB_EP1_IN_CTRL = USB_EP_TOGGLE_CLR | USB_EP_FULL_CLR;
						USB_EP1_OUT_CTRL =  USB_EP_TOGGLE_CLR | USB_EP_FULL_CLR | USB_EP_SETUP_CLR;
					}
					else
					{
						USB_EP1_IN_CTRL = USB_EP_STALL;
						USB_EP1_OUT_CTRL = USB_EP_STALL | USB_EP_SETUP_CLR;
					}

					USB_EP0_OUT_CTRL = USB_EP_STALL;
					USB_EP0_IN_CTRL = USB_EP_IN_CNT(0) | USB_EP_FULL;
				}
				break;
			default:
				USB_EP0_OUT_CTRL = USB_EP_STALL;
				USB_EP0_IN_CTRL = USB_EP_STALL;
			}
		}

		if (SAMPLER_FIFO_CTRL & SAMPLER_FIFO_RDY)
		{
			send("s:");
			sendh(SAMPLER_FIFO_DATA);
			sendch('\n');
			SAMPLER_FIFO_CTRL = SAMPLER_FIFO_RDY;
		}

		if (rx_ready())
		{
			char ch = getch();
			switch (ch)
			{
			case '?':
				sendh((uint16_t)USB_CTRL);
				sendch(':');
				sendh((uint16_t)USB_EP0_IN_CTRL);
				sendch(':');
				sendh((uint16_t)USB_EP0_OUT_CTRL);
				sendch(':');
				sendh((uint16_t)USB_EP1_IN_CTRL);
				sendch(':');
				sendh((uint16_t)USB_EP1_OUT_CTRL);
				sendch('\n');
				break;
			case 'd':
				sendh(DNA_DATA);
				sendch('\n');
				break;
			case 'm':
				DRAM_CTRL = DRAM_ENABLE;
				break;
			case 'M':
				DRAM_CTRL = 0;
				break;
			case 'R':
				read_addr = 0;
				break;
			case 'r':
				{
					uint16_t v = DRAM16[read_addr];

					send("r:");
					sendh(read_addr);
					sendch(':');
					sendh(v);
					sendch('\n');

					++read_addr;
				}
				break;
			case 'W':
				write_addr = 0;
				break;
			case 'w':
				send("w:");
				sendh(write_addr);
				sendch(':');
				sendh(dram_data);
				sendch('\n');
				DRAM16[write_addr++] = dram_data++;
				break;
			case 's':
				SAMPLER_PERIOD = 4700;
				SAMPLER_CTRL = SAMPLER_ENABLE | SAMPLER_CLEAR_PIPELINE | (4<<SAMPLER_LOG_CHANNELS_gp);
				break;
			case 'S':
				SAMPLER_CTRL = 0;
				break;
			default:
				send("unknown command\n");
			}
		}
	}
	return 0;
}
