avakar/omicron2/v2.0/design/ipcore_dir/workspace/sw_0/src/usb_desc.py

import sys
from struct import pack

class DescriptorType:
    DEVICE = 1
    CONFIGURATION = 2
    STRING = 3
    INTERFACE = 4
    ENDPOINT = 5
    DEVICE_QUALIFIER = 6
    OTHER_SPEED_CONFIGURATION = 7
    INTERFACE_POWER = 8
    OTG = 9
    DEBUG = 10
    INTERFACE_ASSOCIATION = 11

    CS_INTERFACE = 0x24
    CS_ENDPOINT = 0x25

class ConfigurationAttributes:
    Sig = (1<<7)
    SelfPowered = (1<<6)
    RemoteWakeup = (1<<5)

class Endpoint:
    Out = (0<<7)
    In = (1<<7)

    Control = 0
    Isochronous = 1
    Bulk = 2
    Interrupt = 3

    NoSynchronization = (0<<2)
    Asynchronous = (1<<2)
    Adaptive = (2<<2)
    Synchronous = (3<<2)

    DataEndpoint = (0<<4)
    FeedbackEndpoint = (1<<4)
    ImplicitFeedbackDataEndpoint = (2<<4)

def DeviceDescriptor(bcdUSB=None, bDeviceClass=None, bDeviceSubClass=None, bDeviceProtocol=None,
        bMaxPacketSize0=None, idVendor=None, idProduct=None, bcdDevice=None,
        iManufacturer=0, iProduct=0, iSerialNumber=0, bNumConfigurations=None):
    return pack('<BBHBBBBHHHBBBB',
        18, DescriptorType.DEVICE,
        bcdUSB, bDeviceClass, bDeviceSubClass, bDeviceProtocol,
        bMaxPacketSize0,
        idVendor, idProduct, bcdDevice,
        iManufacturer, iProduct, iSerialNumber,
        bNumConfigurations)

def ConfigurationDescriptor(bConfigurationValue=None, iConfiguration=0,
        bmAttributes=None, bMaxPower=None, interfaces=None):
    if interfaces:
        intf_count = max((ord(intf[2]) for intf in interfaces)) + 1
    else:
        intf_count = 0
    res = pack('<BBHBBBBB',
        9, DescriptorType.CONFIGURATION,
        9 + sum((len(intf) for intf in interfaces)),
        intf_count,
        bConfigurationValue, iConfiguration, bmAttributes, bMaxPower)
    return res + ''.join(interfaces)

def InterfaceDescriptor(bInterfaceNumber=None, bAlternateSetting=0, bInterfaceClass=0xff,
        bInterfaceSubClass=0xff, bInterfaceProtocol=0, iInterface=0, endpoints=[], functional=[]):
    return pack('<BBBBBBBBB',
        9, DescriptorType.INTERFACE,
        bInterfaceNumber, bAlternateSetting, len(endpoints), bInterfaceClass, bInterfaceSubClass,
        bInterfaceProtocol, iInterface) + ''.join(functional) + ''.join(endpoints)

def EndpointDescriptor(bEndpointAddress=None, bmAttributes=None, wMaxPacketSize=None, bInterval=None):
    return pack('<BBBBHB',
        7, DescriptorType.ENDPOINT,
        bEndpointAddress, bmAttributes, wMaxPacketSize, bInterval)

def StringDescriptor(s):
    s = unicode(s).encode('utf-16-le')
    return pack('<BB', 2 + len(s), DescriptorType.STRING) + s

def LangidsDescriptor(langids):
    return (pack('<BB', 2 + 2*len(langids), DescriptorType.STRING)
        + ''.join((pack('<H', langid) for langid in langids)))

def CdcHeaderDescriptor(bcdCDC):
    return pack('<BBBH', 5, DescriptorType.CS_INTERFACE, 0x00, bcdCDC)

def CdcUnionDescriptor(bControllingInterface, bSubordinateInterfaces):
    return (pack('<BBBB', 4 + len(bSubordinateInterfaces), DescriptorType.CS_INTERFACE, 0x06, bControllingInterface)
        + ''.join((pack('<B', bSubordinateInterface) for bSubordinateInterface in bSubordinateInterfaces)))

def CdcCallManagementDescriptor(bmCapabilities, bDataInterface):
    return pack('<BBBBB', 5, DescriptorType.CS_INTERFACE, 0x01, bmCapabilities, bDataInterface)

def CdcAcmDescriptor(bmCapabilities):
    return pack('<BBBB', 4, DescriptorType.CS_INTERFACE, 0x02, bmCapabilities)

def CustomDescriptor(desc_type, data):
    chunks = []
    while data:
        chunk = data[:253]
        data = data[253:]
        chunks.append(pack('<BB', len(chunk) + 2, desc_type))
        chunks.append(chunk)
    return ''.join(chunks)

def print_descriptors(fout, descriptors, rev_hash=None):
    if 'comment' in descriptors:
        log = descriptors['comment']
        log = '// ' + '\n// '.join(log) + '\n\n'
        fout.write(log)

    fout.write('''\
struct usb_descriptor_entry_t
{
    uint16_t index;
    uint16_t offset;
    uint16_t size;
};

static usb_descriptor_entry_t const usb_descriptor_map[] = {
''')
    data = ''
    for key, value in sorted(descriptors.iteritems()):
        if not isinstance(key, int):
            continue

        oldlen = len(data)
        data += value
        fout.write('    { 0x%03x, 0x%03x, 0x%03x }, // %d\n' % (key, oldlen, len(data) - oldlen, len(data) - oldlen))
    fout.write('};\n\nstatic uint8_t const usb_descriptors[] PROGMEM = {\n')

    if rev_hash:
        rev_hash_pos = data.find(rev_hash)

    while data:
        line = '    '
        for ch in data[:16]:
            line += '0x%0.2x, ' % ord(ch)
        fout.write(line.rstrip())
        fout.write('\n')
        data = data[16:]

    fout.write('};\n')

    if rev_hash:
        fout.write('\nstatic uint16_t const rev_hash_offset = 0x%x;\n' % rev_hash_pos)
