avakar/omicron2/(commit log)

2013-05-17 Initial commit.
    [omicron2.brd, omicron2.sch]
2013-05-22 Final touches.
    [omicron2.brd, omicron2.sch]
2013-05-29 v2.0 component values
    [omicron2.brd, omicron2.sch]
2013-06-02 v2.0: added basic FPGA design
    [omicron2.brd, omicron2.sch]
2013-06-02 v2.0: added uart, usb skeletons
2013-06-02 v2.0: fixed some warnings
    [main.v, uart.v]
2013-06-30 Added a simple sampler, removed UART rx/tx.
2013-07-05 Regenerated cores, sampler, axi_asynch.
2013-07-08 Moved the sampler into aaxi system, disabled sdram.
